XN-H/2026-ti-h-car/report_work/figures/fig3_software_flow.png

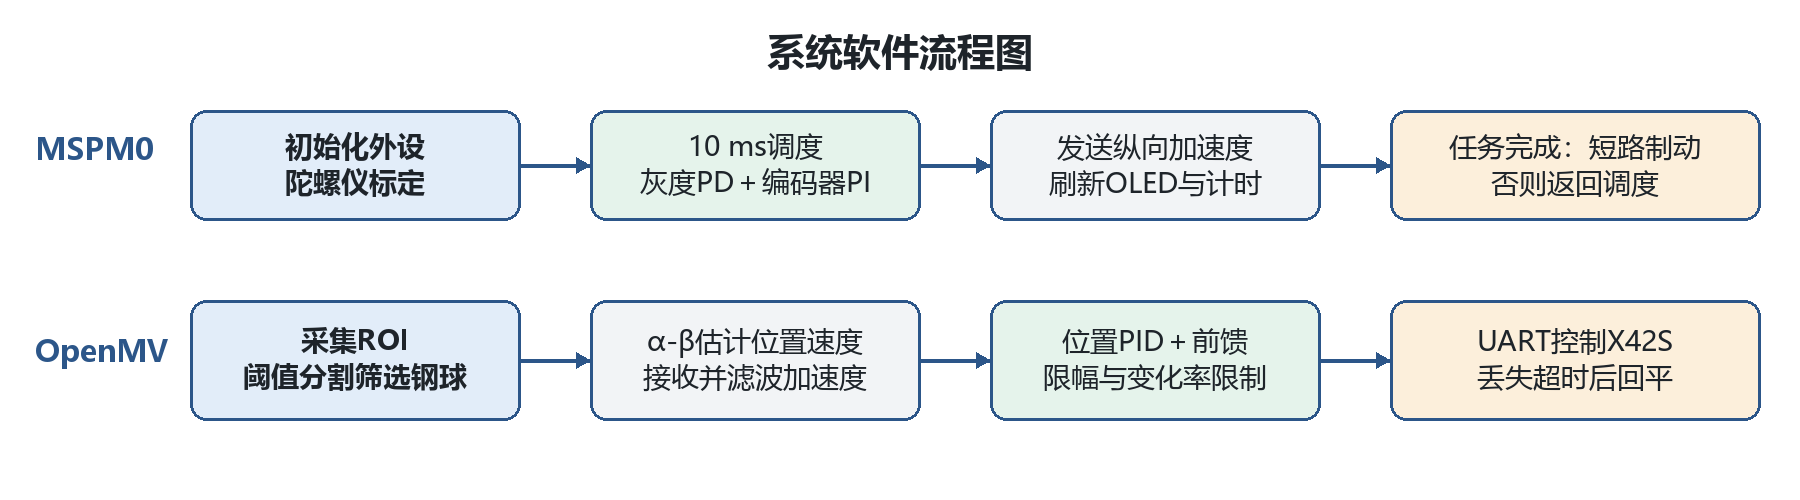
report_work/figures/fig3_software_flow.png
