XN-H/2026-ti-h-car/report_work/source_package_20260801/TI主控源码_MSPM0G3507/encoder_pid.h

#ifndef PID_H
#define PID_H


void PID_Speed_A(int target_speed);
void PID_Speed_B(int target_speed);
void CarSpeedPIDSet(int right_speed,int left_speed);
void CarStraightPIDSet(int right_speed,int left_speed);

#endif
