XN-H/2026-ti-h-car/report_work/source_package_20260801/TI主控源码_MSPM0G3507/motion.h

#ifndef MOTION_H
#define MOTION_H



void SpeedSetA(int speed);
void SpeedStopA(void);

void SpeedSetB(int speed);
void SpeedStopB(void);


void CarForward(int speed);
void CarBack(int speed);
void CarLeft(int speed);
void CarRight(int speed);
void CarStop(void);

void SpeedBrakeA(void);
void SpeedBrakeB(void);
void CarBrake(void);

#endif
